jamct/radio-mailbox/README.md

# Mailbox sensor
ATtiny84 + RFM95 as letterbox sensor as described here: [ct.de/y7yx](https://ct.de/y7yx)
