jamct/radio-mailbox/attiny_mapping.png

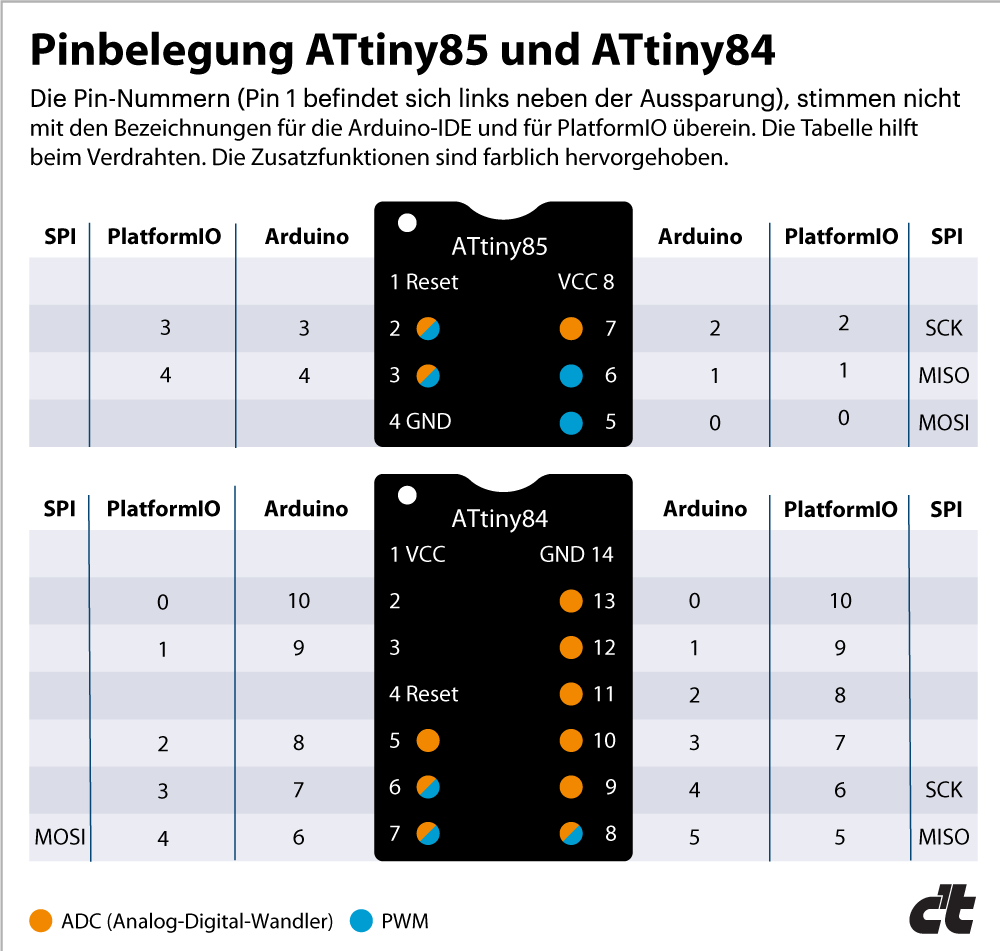
attiny_mapping.png
