jamct/radio-mailbox/00_circuit diagram/briefkastensensor.sch

## KiCad design 00_circuit diagram/briefkastensensor.sch (2019-05-09)

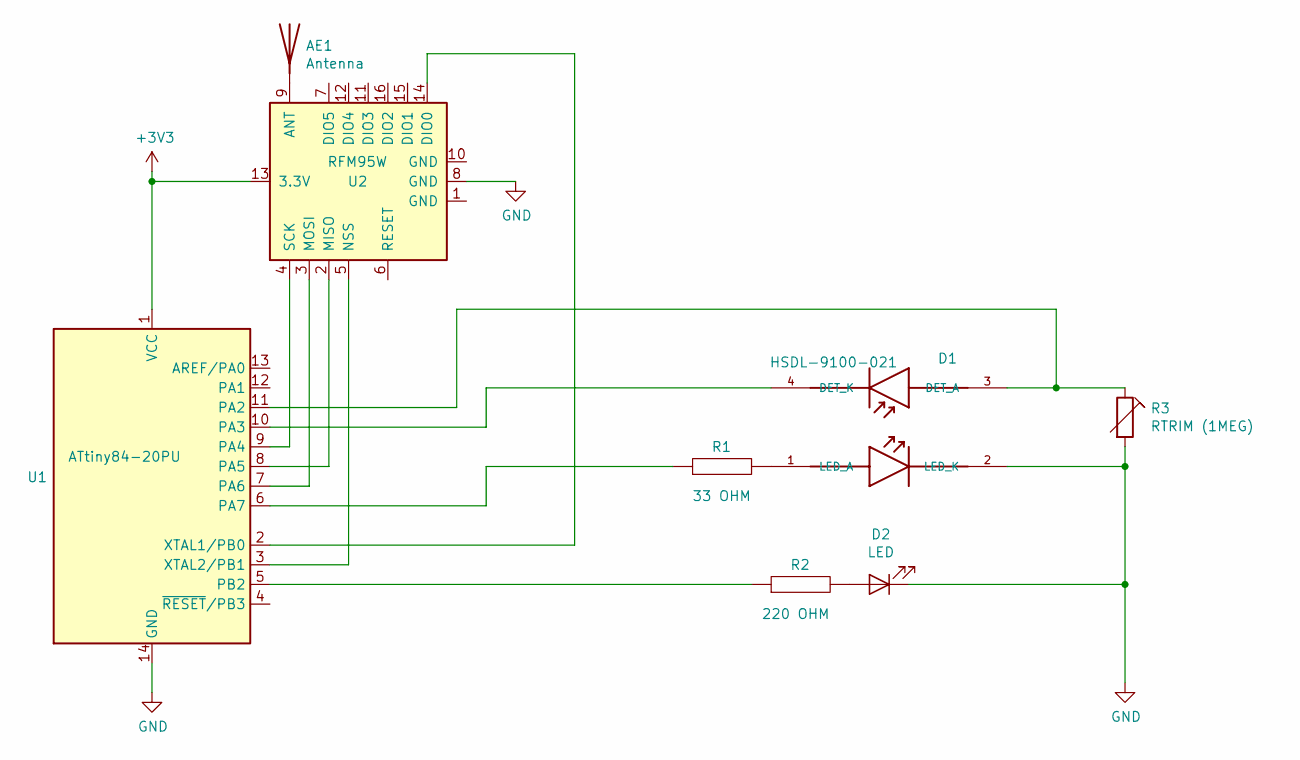
[picture p2: schematic briefkastensensor.sch]

Parts:
AE1: Antenna
D1: HSDL-9100-021; PHODET_HSDL-9100-021
D2: LED
R1: 33 OHM
R2: 220 OHM
R3: RTRIM (1MEG)
U1: ATtiny84-20PU; DIP-14_W7.62mm
U2: RFM95W

Connections:
+3V3: U1.1 (VCC), U2.13 (3.3V)
GND: D1.2 (LED_K), D2.1 (K), R3.2, U1.14 (GND), U2.8 (GND)
unnamed: AE1.1, U2.9 (ANT)
unnamed: D1.1 (LED_A), R1.2
unnamed: D1.3 (DET_A), R3.1, U1.11 (PA2)
unnamed: D1.4 (DET_K), U1.10 (PA3)
unnamed: D2.2 (A), R2.2
unnamed: R1.1, U1.6 (PA7)
unnamed: R2.1, U1.5 (PB2)
unnamed: U1.2 (XTAL1/PB0), U2.14 (DIO0)
unnamed: U1.3 (XTAL2/PB1), U2.5 (NSS)
unnamed: U1.7 (PA6), U2.3 (MOSI)
unnamed: U1.8 (PA5), U2.2 (MISO)
unnamed: U1.9 (PA4), U2.4 (SCK)
