jamct/radio-mailbox/04_sensor_ready/src/secconfig.h

/*
  secconfig.h

  @author  Leo Korbee (c), Leo.Korbee@xs4all.nl
  @website iot-lab.org
  @license Attribution-NonCommercial-ShareAlike 4.0 International (CC BY-NC-SA 4.0)
*/

// Information from The Things Network, device configuration ACTIVATION METHOD: ABP, msb left
unsigned char NwkSkey[16] = { 0xD8, 0x00, 0x00, 0x00, 0x0B, 0x00, 0x00, 0x00, 0x00, 0x00, 0x00, 0x00, 0x00, 0x00, 0x00, 0x00 };
unsigned char AppSkey[16] = { 0x00, 0x00, 0x00, 0x00, 0x00, 0x00, 0x00, 0x00, 0x00, 0x00, 0x00, 0x00, 0x00, 0x00, 0x00, 0x00 };
unsigned char DevAddr[4] = { 0x00, 0x00, 0x00, 0x00 };
