jamct/radio-mailbox/(commit log)

2019-02-13 Added STL and scad files
    [briefkasten.scad]
2019-02-13 folder structure
    [sensor_case.scad]
2019-05-09 Added folder structure
    [briefkastensensor.kicad_pcb, briefkastensensor.sch, sensor_case.scad]
2019-06-01 Fix uninitialized local variable in checkLetter()
    [main.cpp]
2019-07-01 Added pin mapping
